zsl1996/-Electronic-Design-Contest/(list of files, drawings)

Other design files:
JIANGYA.PcbDoc
JIANGYA.SchDoc
PCB1.PcbDoc
Sheet1.SchDoc
